PY050501/-RK3588-/工程说明文档.md

# 六舵机 + 丝杆步进电机 + 无人机座舱 + 液位检测 + 3.5寸 TFT 触摸彩屏 综合控制系统

> **项目版本**: v1.3-TFT
> **更新日期**: 2026年7月5日
> **开发平台**: STM32F103ZE + Keil uVision5
> **芯片封装**: LQFP144（144引脚）

---

## 系统概述

本系统将原有两个 STM32F103C8T6 工程（六舵机控制工程 + 无人机座舱工程）合并迁移至 STM32F103ZE 单芯片平台，并在 v1.2 版本集成 3.5寸 TFTLCD 触摸显示屏。系统集成六路舵机PWM控制、丝杆步进电机控制、无人机座舱步进电机控制、液位检测、温湿度监控、继电器控制、TFT 彩屏看板与电阻触摸等功能，通过统一的 JSON 协议进行串口控制。

### 核心特性

- **六路舵机独立控制** — 支持0-180度精确角度控制
- **丝杆步进电机控制** — 精密线性运动控制，带上下限位保护
- **无人机座舱步进电机** — 28BYJ-48齿轮链条控制（fly命令）
- **液位检测** — ADC模拟量检测，实时百分比回报
- **双协议支持** — JSON命令 + 传统字符串命令兼容
- **实时环境监控** — SI7021温湿度传感器
- **双继电器控制** — 两路独立继电器高电平触发
- **语音控制引脚** — PB10引脚电平控制
- **舵机1自动模式** — 循环自动旋转功能
- **限位保护** — 丝杆步进电机带硬件限位开关保护
- **状态实时回报** — 自动回报角度、温湿度、液位、模式状态
- **3.5寸 TFTLCD 触摸彩屏** — HX8357DN 320×480，FSMC 16位并口驱动，开机动画 + 实时数据看板
- **XPT2046 电阻触摸** — 软件 SPI 驱动，5 点十字校准，校准数据存内部 Flash 末页（无需外置 EEPROM）

---

## 硬件配置

### 引脚分配总表

| 功能 | 引脚 | 外设/模式 | 说明 |
|---|---|---|---|
| **舵机控制** | | | |
| 舵机1 PWM | PA1 | TIM2_CH2 | 支持自动旋转模式，默认100° |
| 舵机2 PWM | PA2 | TIM2_CH3 | 默认50° |
| 舵机3 PWM | PA3 | TIM2_CH4 | 默认90° |
| 舵机4 PWM | PB6 | TIM4_CH1 | 默认90° |
| 舵机5 PWM | PB5 | TIM3_CH2 | 部分重映射，默认0° |
| 舵机6 PWM | PC6 | TIM8_CH1 | 默认180°（v1.3 由 PB7 迁移，PB7=FSMC_NADV 被彩屏占用无法输出PWM） |
| **丝杆步进电机** | | | |
| PUL 脉冲 | PA8 | GPIO Output | 步进电机脉冲信号 |
| DIR 方向 | PB0 | GPIO Output | 步进电机方向控制 |
| ENA 使能 | PB1 | GPIO Output | 低电平有效 |
| 底端限位 | PE0 | EXTI0 Input | 低电平触发（v1.2 由 PE14 迁移） |
| 顶端限位 | PE1 | EXTI1 Input | 低电平触发（v1.2 由 PE15 迁移） |
| **无人机座舱步进电机（28BYJ-48）** | | | |
| IN1 | PB12 | GPIO Output | ULN2003驱动 |
| IN2 | PB13 | GPIO Output | ULN2003驱动 |
| IN3 | PB14 | GPIO Output | ULN2003驱动 |
| IN4 | PB15 | GPIO Output | ULN2003驱动 |
| **液位检测** | | | |
| 液位传感器 | PA0 | ADC1_CH0 | 模拟量输入，0-3.3V |
| **通信与传感器** | | | |
| UART TX | PA9 | USART1 | 串口发送 |
| UART RX | PA10 | USART1 | 串口接收 |
| I2C SCL | PA4 | 软件I2C | SI7021时钟 |
| I2C SDA | PA5 | 软件I2C | SI7021数据 |
| **控制输出** | | | |
| 继电器1 | PB8 | GPIO Output | 高电平启动 |
| 继电器2 | PB9 | GPIO Output | 高电平启动 |
| 语音控制引脚 | PB10 | GPIO Output | 默认高电平 |
| 测试LED | PC13 | GPIO Output | 限位触发指示，低电平点亮 |
| **3.5寸 TFTLCD（HX8357DN）** | | | |
| LCD_CS | PG12 | FSMC_NE4 | 片选，基地址 0x6C000000 |
| LCD_RS | PG0 | FSMC_A10 | 命令/数据选择 |
| LCD_WR | PD5 | FSMC_NWE | 写信号 |
| LCD_RD | PD4 | FSMC_NOE | 读信号 |
| LCD_BL | PB11 | GPIO Output | 背光，高电平点亮（v1.2 由 PB0 迁移）|
| LCD_D0~D15 | PD0/1/8/9/10/14/15, PE7~E15 | FSMC 数据总线 | 16位并口 |
| LCD_RST | NRST | 系统复位 | 与 STM32 共复位 |
| **XPT2046 电阻触摸** | | | |
| T_SCK (TCLK) | PC0 | GPIO Output | 软件 SPI 时钟（v1.2 由 PB1 迁移） |
| T_MISO (DOUT) | PB2 | GPIO Input | XPT2046 输出 |
| T_MOSI (TDIN) | PF9 | GPIO Output | XPT2046 输入 |
| T_CS (TCS) | PF11 | GPIO Output | XPT2046 片选 |
| T_PEN (PEN) | PF10 | GPIO Input | 触摸笔按下检测，低电平 |

### 舵机默认角度配置

| 舵机 | 上电默认角度 | HOME归零角度 | 角度范围 | 备注 |
|---|---|---|---|---|
| 舵机1 | 100° | 100° | 0-180° | 支持自动旋转模式 |
| 舵机2 | 50° | 50° | 0-180° | — |
| 舵机3 | 90° | 90° | 0-180° | — |
| 舵机4 | 90° | 90° | 0-180° | — |
| 舵机5 | 0° | 0° | 0-180° | — |
| 舵机6 | 180° | 0° | 0-180° | 上电180°，HOME归零到0° |

### 无人机座舱步进电机参数

| 参数 | 值 | 说明 |
|---|---|---|
| 电机型号 | 28BYJ-48 | 四相五线减速步进电机 |
| 驱动方式 | ULN2003 | 8拍步进模式 |
| 一圈步数 | 4096步 | 经校准后实际值 |
| 步间延时 | 2ms | Motor_SetSpeed(2) |
| fly=1动作 | 顺时针1.3圈 | 10668步 |
| fly=0动作 | 逆时针1.5圈 | 6144步 |
| 驱动引脚 | PB12-PB15 | GPIOB |

### 丝杆步进电机参数

| 参数 | 值 | 说明 |
|---|---|---|
| 精度 | 320步/mm | 1600步/转，5mm螺距 |
| 限位保护 | 自动反向逃逸30mm | 触发后立即反向 |
| 速度控制 | 可调脉冲频率 | 40-1000μs |

### 液位传感器参数

| 参数 | 值 | 说明 |
|---|---|---|
| ADC通道 | ADC1_CH0 | PA0引脚 |
| 采样精度 | 12位 | 0-4095 |
| 采样次数 | 10次平均 | 提高稳定性 |
| 输出格式 | 百分比 | 0-100% |
| 回报周期 | 1秒 | 自动回报 |

### 液位传感器阈值表

| ADC值范围 | 液位百分比 | 说明 |
|---|---|---|
| ≥ 1100 | 100% | 满液位 |
| 1000-1099 | 90% | — |
| 700-999 | 80% | — |
| 540-699 | 70% | — |
| 400-539 | 60% | — |
| 370-399 | 50% | 中液位 |
| 330-369 | 40% | — |
| 307-329 | 30% | — |
| 260-306 | 20% | — |
| 194-259 | 10% | 低液位 |
| < 194 | 0% | 空液位 |

### 3.5寸 TFTLCD（HX8357DN，FSMC Bank1 NE4，并口 16bit）

LCD 通过 FSMC（Bank1 Sector4）连接，内存映射地址 `0x6C000000`，CPU 以读写内存的方式操作屏幕，速度快且不占用 CPU 轮询时间。

| 屏幕信号 | STM32 引脚 | 复用功能 | 说明 |
|---|---|---|---|
| LCD_BL（背光） | **PB11** | GPIO 推挽 | 高电平点亮（v1.2 由参考工程 PB0 改为 PB11，避让丝杆 DIR） |
| LCD_CS（片选） | PG12 | FSMC_NE4 | 选中 LCD（基地址 0x6C000000） |
| LCD_RS（命令/数据） | PG0 | FSMC_A10 | A10=0 写命令，A10=1 写数据 |
| LCD_WR（写信号） | PD5 | FSMC_NWE | 写脉冲 |
| LCD_RD（读信号） | PD4 | FSMC_NOE | 读脉冲 |
| LCD_RST（复位） | NRST | 系统复位 | 直接接 STM32 NRST |
| LCD_D0 | PD14 | FSMC_D0 | 数据线 0 |
| LCD_D1 | PD15 | FSMC_D1 | 数据线 1 |
| LCD_D2 | PD0 | FSMC_D2 | 数据线 2 |
| LCD_D3 | PD1 | FSMC_D3 | 数据线 3 |
| LCD_D4 | PE7 | FSMC_D4 | 数据线 4 |
| LCD_D5 | PE8 | FSMC_D5 | 数据线 5 |
| LCD_D6 | PE9 | FSMC_D6 | 数据线 6 |
| LCD_D7 | PE10 | FSMC_D7 | 数据线 7 |
| LCD_D8 | PE11 | FSMC_D8 | 数据线 8 |
| LCD_D9 | PE12 | FSMC_D9 | 数据线 9 |
| LCD_D10 | PE13 | FSMC_D10 | 数据线 10 |
| LCD_D11 | PE14 | FSMC_D11 | 数据线 11（v1.2 起独占，原限位已迁至 PE0）|
| LCD_D12 | PE15 | FSMC_D12 | 数据线 12（v1.2 起独占，原限位已迁至 PE1）|
| LCD_D13 | PD8 | FSMC_D13 | 数据线 13 |
| LCD_D14 | PD9 | FSMC_D14 | 数据线 14 |
| LCD_D15 | PD10 | FSMC_D15 | 数据线 15 |

### XPT2046 电阻触摸（软件 SPI）

| 屏幕信号 | STM32 引脚 | 方向 | 说明 |
|---|---|---|---|
| T_SCK（TCLK） | **PC0** | 输出 | 软件 SPI 时钟（v1.2 由参考工程 PB1 改为 PC0，避让丝杆 ENA） |
| T_MOSI（TDIN） | PF9 | 输出 | XPT2046 输入，控制字 |
| T_MISO（DOUT） | PB2 | 输入 | XPT2046 输出，AD 转换结果 |
| T_CS（TCS） | PF11 | 输出 | XPT2046 片选 |
| T_PEN（PEN） | PF10 | 输入 | 触摸笔按下检测，低电平表示有按压 |

### 屏幕显示参数

| 参数 | 值 |
|---|---|
| 控制器 | HX8357DN |
| 分辨率 | 320 × 480 |
| 显示方向 | 0（竖屏） |
| 颜色格式 | RGB565 |
| 触摸方式 | 电阻屏 + XPT2046 软件 SPI |
| 校准方式 | 5 点十字校准（首次上电自动进入） |
| 校准数据存储 | 内部 Flash 末页 `0x0807F800`（2KB 页，共占用 14 字节）|

---

## 软件架构

### 工程文件结构

```
103ZE_USART串口通信实验(加彩屏)/
├── User/
│   ├── main.c                  主程序：JSON解析、系统控制、自动回报、看板刷新
│   ├── stm32f10x_it.c          中断处理（EXTI 限位 ISR 由 StepperMotor.c 提供）
│   ├── stm32f10x_conf.h        库配置
│   └── stm32f10x_it.h
├── Hardware/
│   ├── Servo.c / .h            六路舵机PWM控制
│   ├── PWM.c / .h              PWM基础驱动（TIM2/3/4/8，舵机6用TIM8_CH1/PC6）
│   ├── StepperMotor.c / .h     丝杆步进电机控制（含限位保护，EXTI0/EXTI1）
│   ├── motor.c / .h            无人机座舱步进电机（28BYJ-48）
│   ├── Serial.c / .h           USART1串口通信，命令队列
│   ├── ADC.c / .h              液位检测ADC驱动
│   ├── bsp_si7021.c / .h       SI7021温湿度传感器驱动
│   ├── bsp_i2c.c / .h          软件I2C驱动
│   ├── cJSON.c / .h            JSON解析库
│   ├── tftlcd.c / .h           HX8357DN FSMC 16位并口驱动（v1.2 新增）
│   ├── font.h                  ASCII 12/16/24 + 32×29 汉字字模（v1.2 新增）
│   ├── touch.c / .h            XPT2046 电阻触摸 + 5 点校准（v1.2 新增）
│   ├── 24cxx.c / .h            内部 Flash 末页模拟 EEPROM（存校准数据，v1.2 新增）
│   ├── Display.c / .h          看板：开机动画 + 实时数据差分刷新（v1.2 新增）
│   └── LED.c / .h              LED驱动（已废弃，保留备用）
├── Public/
│   ├── system.c / .h           位带操作宏（PBout/PCin 等，LCD/触摸驱动依赖）
│   ├── SysTick.c / .h          delay_us / delay_ms（LCD/触摸驱动依赖）
│   └── usart.c / .h            仅作头文件提供 printf 引入
├── System/
│   └── Delay.c / .h            延时函数（Delay_ms / Delay_us）
├── Libraries/
│   ├── CMSIS/                  Cortex-M3核心及启动文件（hd高密度）
│   └── STM32F10x_StdPeriph_Driver/  STM32标准外设库
│       ├── stm32f10x_fsmc.c    （v1.2 新增，LCD 必需）
│       ├── stm32f10x_flash.c   （v1.2 新增，校准持久化必需）
│       └── stm32f10x_adc.c     （ADC 标准库）
└── Template.uvprojx            Keil工程文件
```

### 核心全局变量

```c
// 舵机角度（在 Servo.c 中定义，main.c 通过 extern 访问）
extern float Servo1_Angle;   // 舵机1角度 (0-180°)
extern float Servo2_Angle;   // 舵机2角度 (0-180°)
extern float Servo3_Angle;   // 舵机3角度 (0-180°)
extern float Servo4_Angle;   // 舵机4角度 (0-180°)
extern float Servo5_Angle;   // 舵机5角度 (0-180°)
extern float Servo6_Angle;   // 舵机6角度 (0-180°)

// 模式标志（在 main.c 中定义）
uint8_t moshiqiehuan;   // 0=舵机1自动模式, 1=手动模式
uint8_t servo1stop;     // 0=旋转, 1=暂停（仅自动模式下有效）
uint8_t relay_switch;   // 继电器1状态
uint8_t relay_switch1;  // 继电器2状态
uint8_t yuyin_state;    // 语音引脚状态
```

### 主循环时序规划（50ms周期，1秒循环）

| tick值 | 时间偏移 | 动作 |
|---|---|---|
| 0 | 0ms | 回报舵机1-4角度 |
| 4 | 200ms | 回报舵机5-6角度 |
| 8 | 400ms | 读取并回报温湿度（SI7021） |
| 12 | 600ms | 读取并回报液位百分比 |
| 16 | 800ms | 回报模式状态 |
| 每tick | 每50ms | 串口命令处理、舵机1自动旋转、舵机角度更新、限位LED闪烁、TFTLCD 看板差分刷新 |

---

## 通信协议

### 串口配置

| 参数 | 值 |
|---|---|
| 接口 | USART1（PA9-TX，PA10-RX） |
| 波特率 | 115200 bps |
| 数据位 | 8位 |
| 停止位 | 1位 |
| 校验位 | 无 |
| 命令结束符 | `\r` 或 `\n` |
| 命令队列深度 | 4条 |

---

## 串口调试命令速查表

### 舵机控制命令（JSON格式）

| 功能 | 命令示例 | 说明 |
|---|---|---|
| 单个舵机 | `{"servo1": 90}` | 设置舵机1到90度 |
| 单个舵机 | `{"servo2": 45}` | 设置舵机2到45度 |
| 单个舵机 | `{"servo3": 60}` | 设置舵机3到60度 |
| 单个舵机 | `{"servo4": 120}` | 设置舵机4到120度 |
| 单个舵机 | `{"servo5": 90}` | 设置舵机5到90度 |
| 单个舵机 | `{"servo6": 135}` | 设置舵机6到135度 |
| 多舵机同时 | `{"servo1": 90, "servo2": 45}` | 同时设置多个舵机 |
| 六舵机同时 | `{"servo1":90,"servo2":45,"servo3":60,"servo4":120,"servo5":90,"servo6":135}` | 设置所有舵机 |

### 舵机控制命令（传统字符串格式）

| 命令 | 功能 |
|---|---|
| `S1G1` / `S1G2` / `S1G3` / `S1G4` | 舵机1到档位1/2/3/4 |
| `S1HOME` | 舵机1归零 |
| `S2G1` ~ `S2G4` / `S2HOME` | 舵机2控制 |
| `S3G1` ~ `S3G4` / `S3HOME` | 舵机3控制 |
| `S4G1` ~ `S4G4` / `S4HOME` | 舵机4控制 |
| `BOTH1` ~ `BOTH4` / `BOTHOME` | 同时控制舵机1和2 |
| `ALL1` ~ `ALL4` / `ALLHOME` | 所有舵机同时到档位/归零 |

### 丝杆步进电机控制命令

| 功能 | 命令示例 | 说明 |
|---|---|---|
| 上升 | `{"motor": "up", "distance": 100}` | 上升100mm |
| 上升（中文） | `{"motor": "shang", "distance": 50}` | 上升50mm |
| 下降 | `{"motor": "down", "distance": 80}` | 下降80mm |
| 下降（中文） | `{"motor": "xia", "distance": 30}` | 下降30mm |

注意：限位触发后自动反向逃逸30mm，PC13 LED闪烁1秒。

### 无人机座舱步进电机控制命令

| 功能 | 命令 | 说明 |
|---|---|---|
| fly开 | `{"fly": 1}` | 顺时针旋转1.3圈（齿轮链条前进） |
| fly关 | `{"fly": 0}` | 逆时针旋转1.5圈回起点 |

响应示例：`{"cmd_id":1,"fly_set":1}`

### 快捷动作命令

| 功能 | 命令 | 说明 |
|---|---|---|
| 全部归零 | `{"action": "home"}` | 舵机1→100°，舵机2→50°，舵机3/4→90°，舵机5/6→0° |
| 查询状态 | `{"action": "status"}` | 返回所有舵机角度及当前模式 |

状态查询返回示例：
```json
{"servo1":100.0,"servo2":50.0,"servo3":90.0,"servo4":90.0,"servo5":0.0,"servo6":0.0,"auto":1,"status":"ok"}
```

### 舵机1自动模式控制命令

| 功能 | 命令 | 说明 |
|---|---|---|
| 启用自动模式 | `{"auto": 0}` | 舵机1进入自动旋转（0→180→0循环） |
| 切换手动模式 | `{"auto": 1}` | 舵机1恢复手动控制 |
| 暂停自动旋转 | `{"servo1stop": 1}` | 仅自动模式下有效 |
| 恢复自动旋转 | `{"servo1stop": 0}` | 仅自动模式下有效 |

注意：自动模式下舵机1拒绝手动角度设置，会返回 `{"error":"Servo1 in auto mode"}`。

### 继电器控制命令

| 功能 | 命令 | 说明 |
|---|---|---|
| 打开继电器1 | `{"switch": 1}` | PB8输出高电平 |
| 关闭继电器1 | `{"switch": 0}` | PB8输出低电平 |
| 打开继电器2 | `{"switch1": 1}` | PB9输出高电平 |
| 关闭继电器2 | `{"switch1": 0}` | PB9输出低电平 |
| 同时控制 | `{"switch": 1, "switch1": 1}` | 同时打开两个继电器 |

### 语音控制引脚命令

| 功能 | 命令 | 说明 |
|---|---|---|
| 高电平 | `{"yuyin": 0}` | PB10输出高电平（默认状态） |
| 低电平 | `{"yuyin": 1}` | PB10输出低电平 |

---

## 实时数据自动回报

系统每秒自动回报5类数据，时序错开避免串口缓冲冲突：

| tick | 回报内容 | 格式示例 |
|---|---|---|
| 0 | 舵机1-4角度 | `{"servo1":100.0,"servo2":50.0,"servo3":90.0,"servo4":90.0}` |
| 4 | 舵机5-6角度 | `{"servo5":0.0,"servo6":0.0}` |
| 8 | 温湿度数据 | `{"temp":25.36,"humi":60.12}` |
| 12 | 液位百分比 | `{"yewei":50}` |
| 16 | 模式状态 | `{"auto":1,"servo1stop":0,"switch":0,"switch1":0,"yuyin":0}` |

传感器连续失败3次后静默跳过，不再尝试读取，防止I2C挂死。

---

## 命令响应格式

### 成功响应

```json
{"cmd_id":1,"servo1_set":90}
{"cmd_id":2,"motor_executed":"up","distance_mm":100}
{"cmd_id":3,"switch_set":1}
{"cmd_id":4,"fly_set":1}
{"cmd_id":5,"auto_set":0}
```

### 错误响应

```json
{"error":"Invalid JSON format","received":"..."}
{"error":"Servo1 in auto mode"}
{"error":"Unknown legacy command","received":"..."}
{"error":"SI7021 sensor read error","temp_raw":999.00,"humi_raw":999.00}
```

---

## 测试命令组合示例

### 场景1：快速功能测试

```
1. {"action": "status"}                     查询当前状态
2. {"servo1": 90, "servo2": 45}             测试舵机控制
3. {"motor": "up", "distance": 10}          测试丝杆步进电机上升10mm
4. {"motor": "down", "distance": 10}        测试丝杆步进电机下降10mm
5. {"fly": 1}                               测试座舱电机顺时针1.3圈
6. {"fly": 0}                               测试座舱电机逆时针1.5圈
7. {"switch": 1}                            测试继电器1打开
8. {"switch1": 1}                           测试继电器2打开
9. {"switch": 0, "switch1": 0}              同时关闭两个继电器
10. {"action": "home"}                      所有舵机归零
```

### 场景2：舵机1自动模式测试

```
1. {"auto": 0}          启用自动模式
2. 等待5秒观察旋转...
3. {"servo1stop": 1}    暂停自动旋转
4. {"servo1stop": 0}    恢复自动旋转
5. {"auto": 1}          切换回手动模式
6. {"servo1": 90}       手动设置角度
```

### 场景3：丝杆步进电机限位测试

```
1. {"motor": "down", "distance": 500}   下降直到触发底端限位
   （触发后自动反向逃逸30mm，PC13 LED闪烁1秒）
2. {"motor": "up", "distance": 500}     上升直到触发顶端限位
   （触发后自动反向逃逸30mm，PC13 LED闪烁1秒）
```

---

## 引脚总览图

```
STM32F103ZE 本工程使用引脚

PA0  ──→  液位传感器 ADC (ADC1_CH0)
PA1  ──→  舵机1 PWM (TIM2_CH2)         默认100°
PA2  ──→  舵机2 PWM (TIM2_CH3)         默认50°
PA3  ──→  舵机3 PWM (TIM2_CH4)         默认90°
PA4  ──→  SI7021 SCL (软件I2C)
PA5  ──→  SI7021 SDA (软件I2C)
PA8  ──→  丝杆步进电机 PUL (脉冲)
PA9  ──→  USART1 TX
PA10 ──→  USART1 RX

PB0  ──→  丝杆步进电机 DIR (方向)
PB1  ──→  丝杆步进电机 ENA (使能，低电平有效)
PB5  ──→  舵机5 PWM (TIM3_CH2 部分重映射) 默认0°
PB6  ──→  舵机4 PWM (TIM4_CH1)         默认90°
PB8  ──→  继电器1 (高电平启动)
PB9  ──→  继电器2 (高电平启动)
PB10 ──→  语音控制引脚 (默认高电平)
PB12 ──→  座舱步进电机 IN1 (28BYJ-48)
PB13 ──→  座舱步进电机 IN2
PB14 ──→  座舱步进电机 IN3
PB15 ──→  座舱步进电机 IN4

PC6  ──→  舵机6 PWM (TIM8_CH1)         默认180°（v1.3 由 PB7 迁移）
PC13 ──→  测试LED (限位触发指示，低电平点亮)

（PB7 空置：其 FSMC_NADV 功能被彩屏 FSMC 占用，不接任何外设）

PE0  ──→  丝杆底端限位 (EXTI0，低电平触发)
PE1  ──→  丝杆顶端限位 (EXTI1，低电平触发)
```

---

## 开发环境

| 项目 | 参数 |
|---|---|
| IDE | Keil uVision5 |
| 芯片 | STM32F103ZET6 |
| 启动文件 | startup_stm32f10x_hd.s（高密度） |
| 标准库 | STM32F10x_StdPeriph_Driver v3.5.0 |
| 编译器 | ARM Compiler V5.06 update 7 |
| C标准 | C99 Mode |
| 波特率 | 115200 |

---

## 注意事项

### 硬件连接

1. **舵机供电**：建议使用独立5V电源，GND与主控共地
2. **丝杆步进电机**：确认驱动器细分参数（1600步/转）
3. **座舱步进电机**：28BYJ-48通过ULN2003驱动板连接PB12-15，5V供电
4. **液位传感器**：PA0引脚，输出模拟电压0-3.3V
5. **限位开关**：使用常开触点，按下时接地，接 PE0（底端）和 PE1（顶端）
6. **SI7021**：3.3V供电，需要上拉电阻

### 软件使用

1. **自动模式**：舵机1在自动模式（auto=0）下拒绝手动角度设置
2. **步进电机**：限位触发后会自动反向逃逸，属正常现象
3. **液位检测**：阈值可根据实际传感器特性调整（ADC.c中）
4. **fly命令**：执行期间为阻塞操作，电机转动完成后才能处理下一条命令
5. **JSON格式**：严格使用双引号，命令后加 `\r` 或 `\n`

### 故障排查

| 现象 | 排查方向 |
|---|---|
| 舵机不响应 | 检查PWM引脚接线和5V供电 |
| 舵机6不动 | 信号线须接 **PC6**（非旧版 PB7）；PB7 已被彩屏 FSMC 占用无法输出 |
| 丝杆步进电机不动 | 检查PA8/PB0/PB1接线，ENA低电平有效 |
| 座舱电机不转 | 检查PB12-15接线，ULN2003供电 |
| 液位检测异常 | 检查PA0连接，观察ADC原始值 |
| 温湿度不更新 | 检查PA4/PA5 I2C上拉电阻 |
| 命令无响应 | 确认波特率115200，检查JSON格式 |
| 自动模式无法手动 | 先发 `{"auto": 1}` 切换到手动模式 |

---

## 版本历史

| 版本 | 日期 | 说明 |
| --- | --- | --- |
| v1.0 | 2026-05-03 | 将六舵机工程（C8）+ 无人机座舱工程（C8）合并迁移至 STM32F103ZE |
| v1.1 | 2026-05-03 | 丝杆限位引脚由 PC14/PC15 更换为 PE14/PE15，修正舵机6上电默认角度（180°） |
| v1.2-TFT | 2026-06-17 | 集成 3.5寸 TFTLCD 触摸彩屏（HX8357DN + XPT2046）。FSMC 16位 + 软件 SPI 触摸。校准数据持久化到内部 Flash 末页（0x0807F800），无需外置 EEPROM。引脚迁移：丝杆限位 PE14/PE15→**PE0/PE1**（让出 FSMC_D11/D12）；LCD 背光 PB0→**PB11**；触摸 TCLK PB1→**PC0**。新增源文件：`tftlcd.c/h`、`touch.c/h`、`24cxx.c/h`、`Display.c/h`、`font.h`，外加标准库 `stm32f10x_fsmc.c`、`stm32f10x_flash.c`、`stm32f10x_adc.c`。 |
| v1.3-TFT | 2026-07-05 | 修复舵机6无PWM输出问题。根因：PB7 兼具 FSMC_NADV 功能，彩屏 FSMC 使能后 PB7 被硬件占用，TIM4_CH2 无法在该脚输出（PB6/TIM4_CH1 不受影响，因 PB6 非 FSMC 引脚）。舵机6 由 **PB7/TIM4_CH2 迁移至 PC6/TIM8_CH1**（PC6 全工程空闲的硬件 PWM 脚）。TIM8 为高级定时器，PWM 输出额外调用 `TIM_CtrlPWMOutputs(TIM8, ENABLE)` 使能主输出(MOE)。上层 `Servo.c`、JSON `servo6` 命令、`Servo6_Angle` 均不变。**接线变更：舵机6 信号线由 PB7 改插 PC6，PB7 空置。** 同时订正文档笔误：舵机5 引脚 PA7→**PB5**（TIM3_CH2 部分重映射，与代码一致）。 |

---

*本文档基于 STM32F103ZE 综合控制系统 v1.3-TFT 版本编写*
