PY050501/-RK3588-/Hardware/PWM.h

#ifndef __PWM_H
#define __PWM_H

void PWM_Init(void);
void PWM_SetCompare2(uint16_t Compare);  // TIM2通道2 (PA1-舵机1)
void PWM_SetCompare3(uint16_t Compare);  // TIM2通道3 (PA2-舵机2)
void PWM_SetCompare4(uint16_t Compare);  // TIM2通道4 (PA3-舵机3)
void PWM_SetCompare4_TIM4(uint16_t Compare);  // TIM4通道1 (PB6-舵机4)
void PWM_SetCompare2_TIM3(uint16_t Compare);  // TIM3通道2 (PB5-舵机5，部分重映射)
void PWM_SetCompare2_TIM4(uint16_t Compare);  // 舵机6：已迁移到 TIM8通道1 (PC6)，函数名保留兼容调用处

#endif
