PY050501/-RK3588-/Hardware/Serial.h

#ifndef __SERIAL_H
#define __SERIAL_H

#include <stdio.h>

extern char Serial_RxPacket[];
extern volatile uint8_t Serial_RxFlag;

uint8_t Serial_GetCommand(char *cmd_buffer, uint16_t buffer_size);

void Serial_Init(void);
void Serial_SendByte(uint8_t Byte);
void Serial_SendArray(uint8_t *Array, uint16_t Length);
void Serial_SendString(char *String);
void Serial_SendNumber(uint32_t Number, uint8_t Length);
void Serial_Printf(char *format, ...);

#endif
