PY050501/-RK3588-/(commit log)

2026-07-08 Initial commit: 嵌入式设计竞赛代码 (STM32F103 Keil project)
2026-07-08 森林防火检测系统 (RK3588) - 脱敏版
    - 彩色+热红外双摄 YOLOv8 火焰/动物检测 (RKNN NPU)
    - 自动灭火状态机 + 华为云 IoT 上报 + RTP 视频流
    - 敏感凭据改为环境变量注入, 代码不含真实密钥
2026-07-08 添加 README / .gitignore / .env.example
2026-07-08 RK3588 说明改名为 README_RK3588.md, 避免与远程工程 README 冲突
2026-07-08 完善 README: 合并 RK3588 上位机 + STM32 下位机说明
2026-07-08 README 添加演示视频下载链接
2026-07-08 添加项目报告: 嵌入式设计竞赛.pdf
2026-07-08 README 添加项目报告链接
